sensorsensei/integrated-circuit/intg circt.kicad_pcb

## KiCad design intg circt.kicad_pcb (2026-10-06)

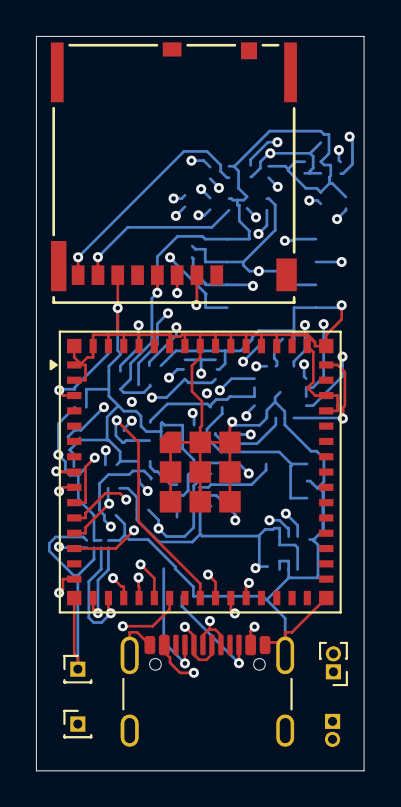
[picture p1: board intg circt.kicad_pcb from above]

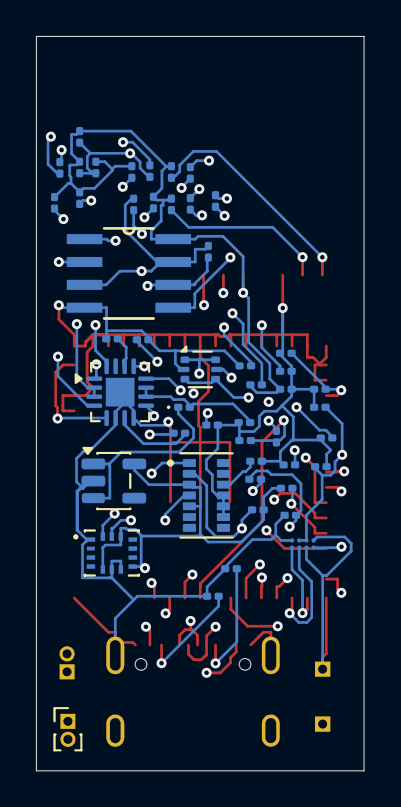
[picture p2: board intg circt.kicad_pcb from below]

Board: 4 copper layers, 18.2 x 40.8 mm, 55 parts (49 on the bottom side), 39 nets.

Parts:
C1, C2, C7: 1uF; C_0201_0603Metric
C3, C16, C17, C18: 0.1uF; C_0201_0603Metric
C4, C8, C9, C10, C11, C15: 100nF; C_0201_0603Metric
C5, C6: 4.7uF; C_0201_0603Metric
C12, C13, C14: 10pF; C_0201_0603Metric
D2: D_Schottky; D_0201_0603Metric
J1, J6: Conn_01x01_Pin; PinHeader_1x01_P1.00mm_Vertical
J2: USB_C_Receptacle_USB2.0_16P; USB_C_Receptacle_GCT_USB4105-xx-A_16P_TopMnt_Horizontal
J3, J5: Conn_01x02_Pin; PinHeader_1x02_P1.00mm_Vertical
J4: 5033981892; CONN_503398-1892_MOL
R1: 46K4R; R_0201_0603Metric
R2: 1K18R; R_0201_0603Metric
R3: 1K13R; R_0201_0603Metric
R4, R5: 10KR; R_0201_0603Metric
R6, R7: 5K1R; R_0201_0603Metric
R8, R9: 4K7R; R_0201_0603Metric
R10, R11: 22R; R_0201_0603Metric
R12, R13, R14, R15, R16: 10kR; R_0201_0603Metric
R17, R19, R20, R21: 100KR; R_0201_0603Metric
R18: 1MR; R_0201_0603Metric
TH1: 10KR; R_0201_0603Metric
U1: ESP32-S3-MINI-1U; ESP32-S2-MINI-1U
U2: MAXM86161EFD_T; PSON60P430X290X150-14N
U3: BMI270; XDCR_BMI270
U4: BQ24074RGT; VQFN-16-1EP_3x3mm_P0.5mm_EP1.6x1.6mm
U6: USBLC6-2P6; SOT-666
U7: MAX17048X+T10; 21-0555B_W80B1-1_MXM
U8: TLV75533PDBV; SOT-23-5
U9: LMV358IDR

Connections:
+3V3: C4.2, C9.2, C11.1, C14.1, C15.1, C18.1, J3.1, J4.4 (VDD), J6.1 (Pin_1_1), R4.1, R5.1, R8.1, R9.2, R12.1, R13.1, R14.1, R15.1, R16.1, R21.1, U1.3 (3V3), U1.45 (EN), U2.3 (LDO_EN), U2.5 (VLED), U3.5 (VDDIO), U3.8 (VDD), U3.12 (CSB), U4.5 (EN2), U8.5 (OUT), U9.8 (V+)
/D+: J2.A6 (D+), J2.B6 (D+), R11.2, U6.3 (I/O2), U6.4 (I/O2)
/D-: J2.A7 (D-), J2.B7 (D-), R10.1, U6.1 (I/O1), U6.6 (I/O1)
/INB-: C16.2, R17.2, R19.2, U9.6 (INB-)
/J1_CD: J4.2 (CD/DAT3), R12.2, U1.19 (IO15)
/J1_CMD: J4.3 (CMD), R13.2, R16.2, U1.20 (IO16)
/J1_DAT0: J4.7 (DA0), R14.2, U1.21 (IO17)
/J1_DAT1: J4.8 (DAT1), R15.2
/OUT_A: C3.2, R17.1, R18.2, U1.10 (IO6), U9.1 (OUT_A)
/OUT_B: C16.1, R19.1, U1.11 (IO7), U9.3 (INA+), U9.7 (OUT_B)
/Temp_SCL: J5.2, U1.26 (IO26)
/Temp_SDA: J5.1, U1.25 (IO21)
/U1_BAT: C5.2, C8.1, U4.2 (BAT), U4.3 (BAT), U7.A2 (CELL), U7.A3 (VDD)
/U2_SDA: R8.2, U1.12 (IO8), U2.1 (SDA)
/U2_SDC: R9.1, U1.13 (IO9), U2.2 (SCL)
/U3_SCX: U1.9 (IO5), U3.13 (SCX)
/U3_SDX: U1.8 (IO4), U3.14 (SDX)
/U4_OUT: C6.2, D2.2 (A), U4.10 (OUT), U4.11 (OUT)
/U5_SCL: U1.17 (IO13), U7.B2 (SCL)
/U5_SDA: U1.16 (IO12), U7.B1 (SDA)
/USB_D+: C12.2, R11.1, U1.24 (USB_D+)
/USB_D-: C13.2, R10.2, U1.23 (USB_D-)
/VBUS: C7.2, C10.1, J2.A4 (VBUS), J2.A9 (VBUS), J2.B4 (VBUS), J2.B9 (VBUS), U4.13 (IN), U6.5 (VBUS)
/VLDO: C2.1, U2.4 (VLDO)
/VREF: C1.1, U2.12 (VREF)
/skin++: C3.1, J3.2, R18.1, U9.2 (INA-)
/~CE: U1.15 (IO11), U4.4 (~CE)
/~CHG: R4.2, U4.9 (~CHG)
/~PGOOD: R5.2, U4.7 (~PGOOD)
/~U5_ALERT: U1.18 (IO14), U7.B4 (*ALRT)
GND: C1.2, C2.2, C4.1, C5.1, C6.1, C7.1, C8.2, C9.1, C10.2, C11.2, C12.1, C13.1, C14.2, C15.2, C17.2, C18.2, J1.1 (Pin_1_1), J2.A1 (GND), J2.A12 (GND), J2.B1 (GND), J2.B12 (GND), J2.SH (SHIELD), J4.6 (VSS), R1.1, R2.1, R3.1, R6.1, R7.1, R20.2, TH1.2, U1.1 (GND), U1.2 (GND), U1.42 (GND), U1.43 (GND), U1.46 (GND), U1.47 (GND), U1.48 (GND), U1.49 (GND), U1.50 (GND), U1.51 (GND), U1.52 (GND), U1.53 (GND), U1.54 (GND), U1.55 (GND), U1.56 (GND), U1.57 (GND), U1.58 (GND), U1.59 (GND), U1.60 (GND), U1.61 (GND), U1.62 (GND), U1.63 (GND), U1.64 (GND), U1.65 (GND), U2.9 (PGND), U2.10 (GND_DIG), U2.11 (GND_ANA), U3.1 (SDO), U3.6 (GNDIO), U3.7 (GND), U4.6 (EN1), U4.8 (VSS), U4.17 (VSS), U6.2 (GND), U7.A1 (CTG), U7.A4 (GND), U7.B3 (QSTRT), U8.2 (GND), U9.4 (V-)
unnamed: D2.1 (K), U8.1 (IN), U8.3 (EN)
unnamed: J2.A5 (CC1), R6.2
unnamed: J2.B5 (CC2), R7.2
unnamed: R2.2, U4.12 (ILIM)
unnamed: R3.2, U4.16 (ISET)
unnamed: R1.2, U4.14 (TMR)
unnamed: TH1.1, U4.1 (TS)
unnamed: C17.1, R20.1, R21.2, U9.5 (INB+)
